Wrench-Wielders-Racing/BMS/Master_V0.1/Master_V0.1_brd_front.pdf

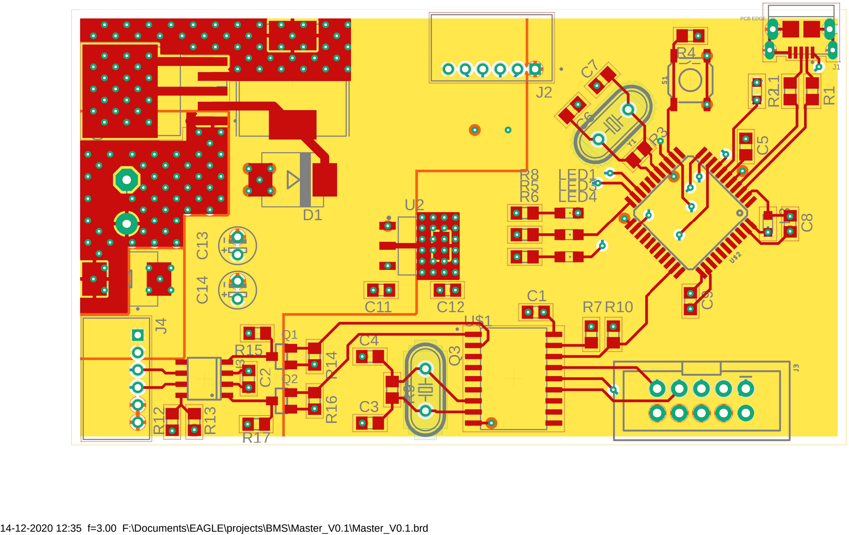
[picture p1: page 1]

14-12-2020 12:35 f=3.00 F:\Documents\EAGLE\projects\BMS\Master_V0.1\Master_V0.1.brd
