Wrench-Wielders-Racing/BMS/Slave_V0.1/Slave_V0.1_BRD.pdf

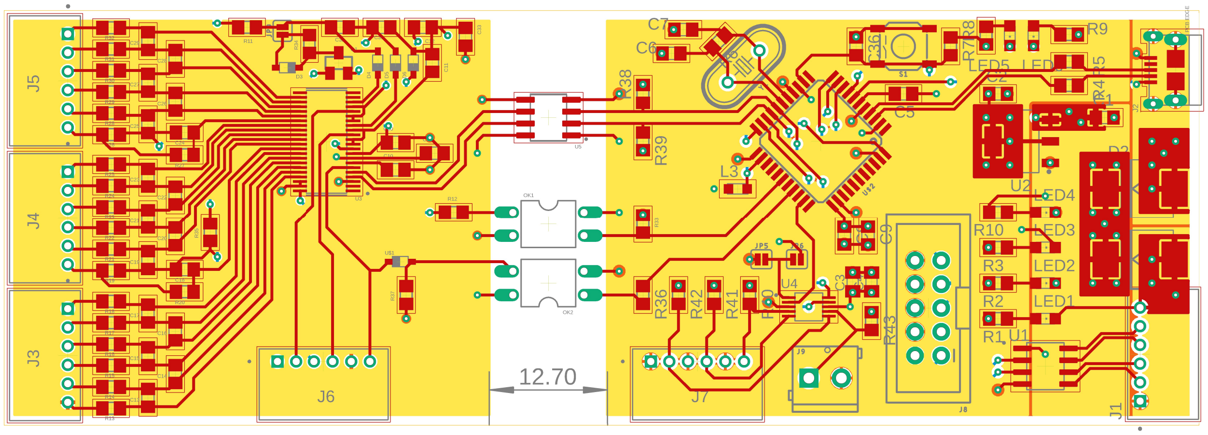
[picture p2: figure]

14-12-2020 15:32 f=2.20 F:\Documents\EAGLE\projects\BMS\Slave_V0.1\Slave_V0.1.brd
