Wrench-Wielders-Racing/BMS/Master_V0.1/Master_V0.1_sch.pdf

# 6 J2

A

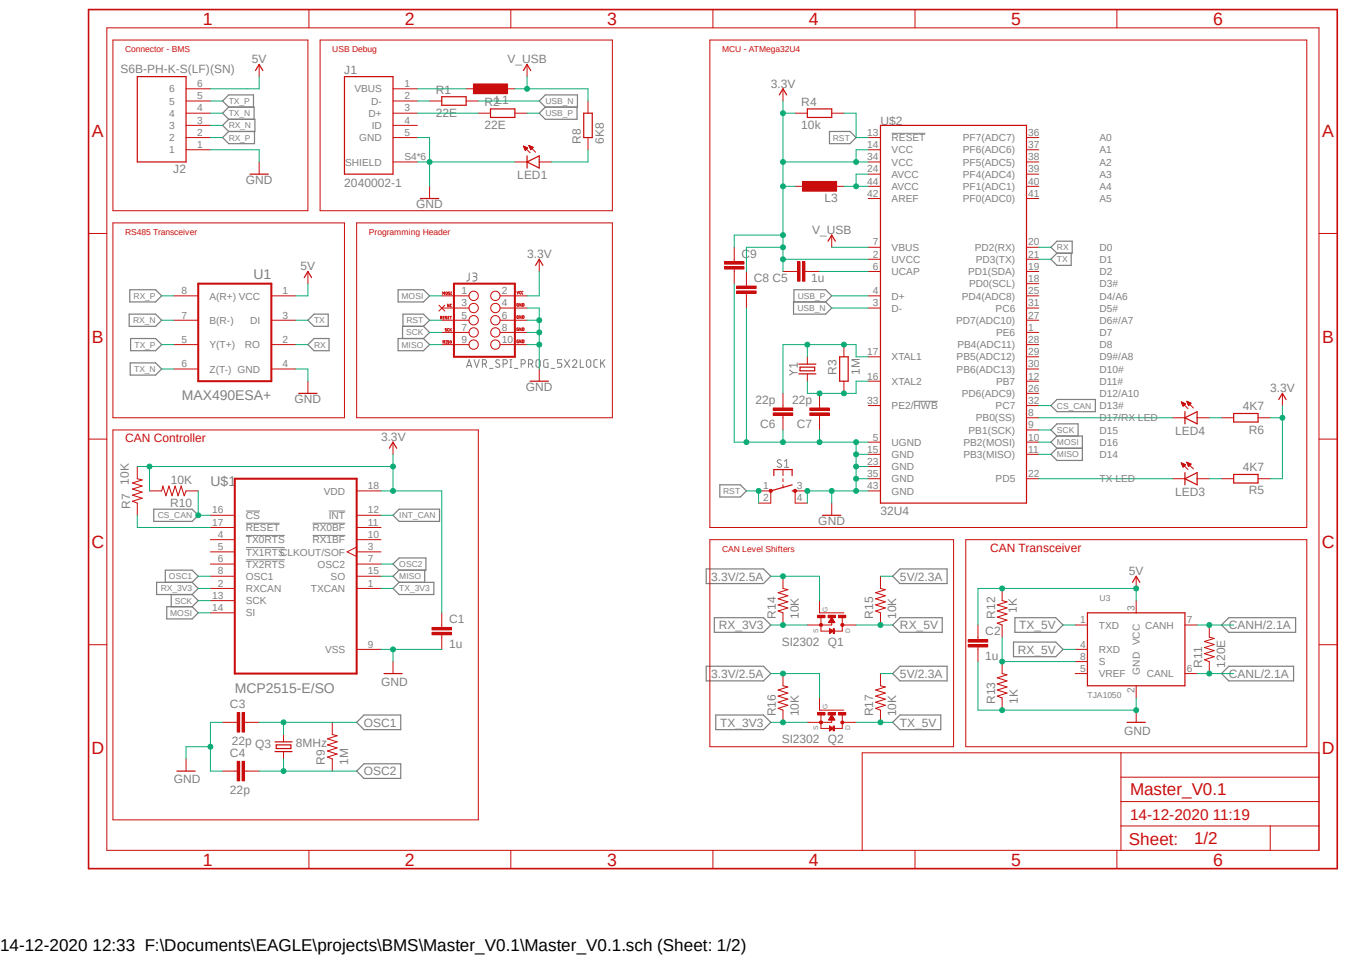
[picture p3: page 1]

14-12-2020 12:33 F:\Documents\EAGLE\projects\BMS\Master_V0.1\Master_V0.1.sch (Sheet: 1/2)

## AMS1117

## LM2596SX-ADJ/NOPB

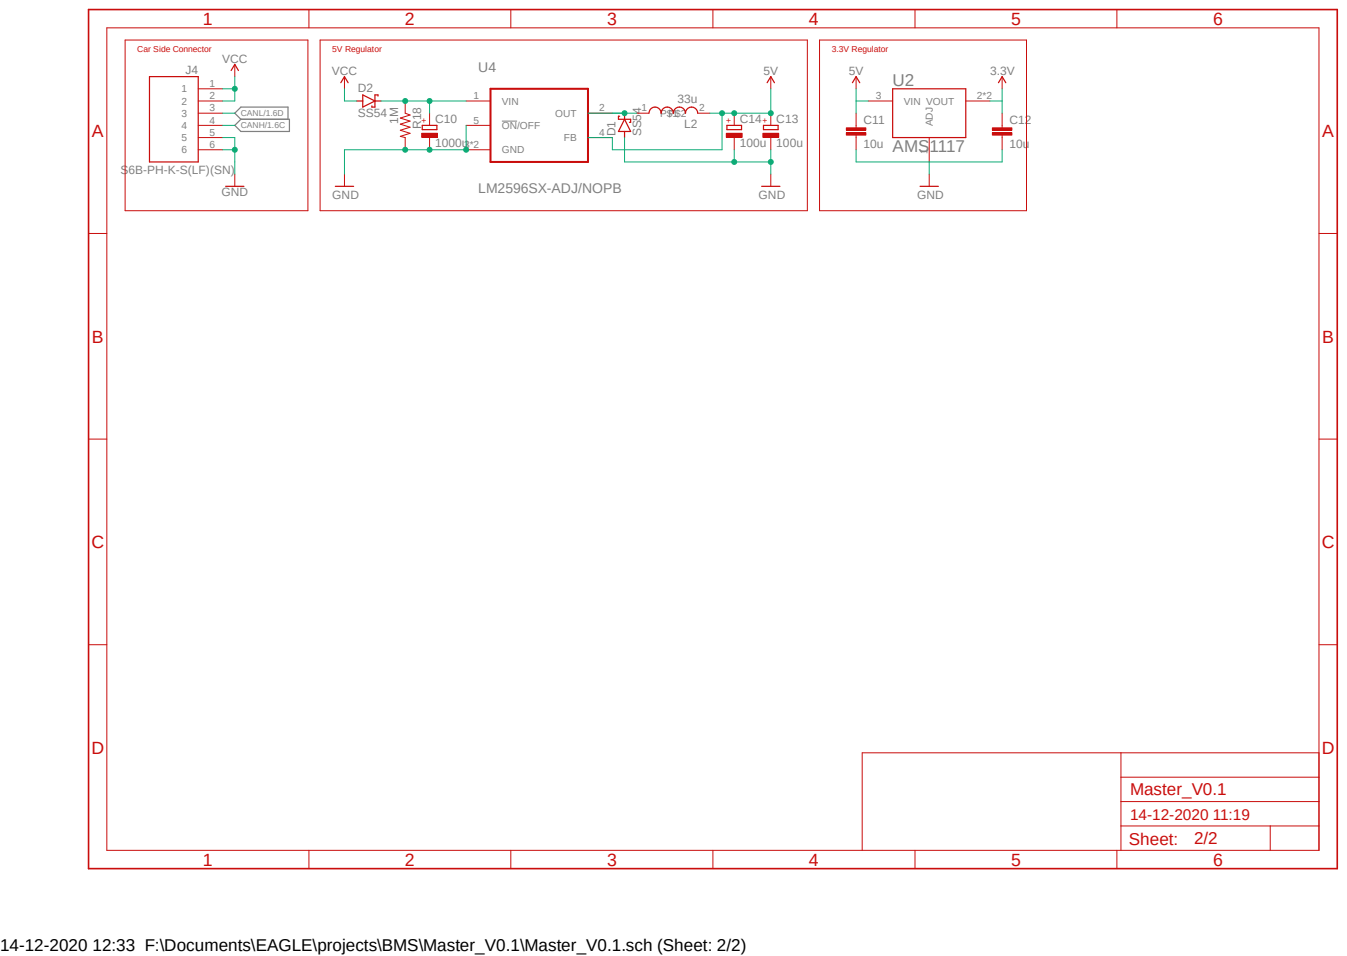
[picture p4: page 2]

14-12-2020 12:33 F:\Documents\EAGLE\projects\BMS\Master_V0.1\Master_V0.1.sch (Sheet: 2/2)
