Wrench-Wielders-Racing/BMS/Slave_V0.1/Slave_V0.1.pdf

# 6 J1

A

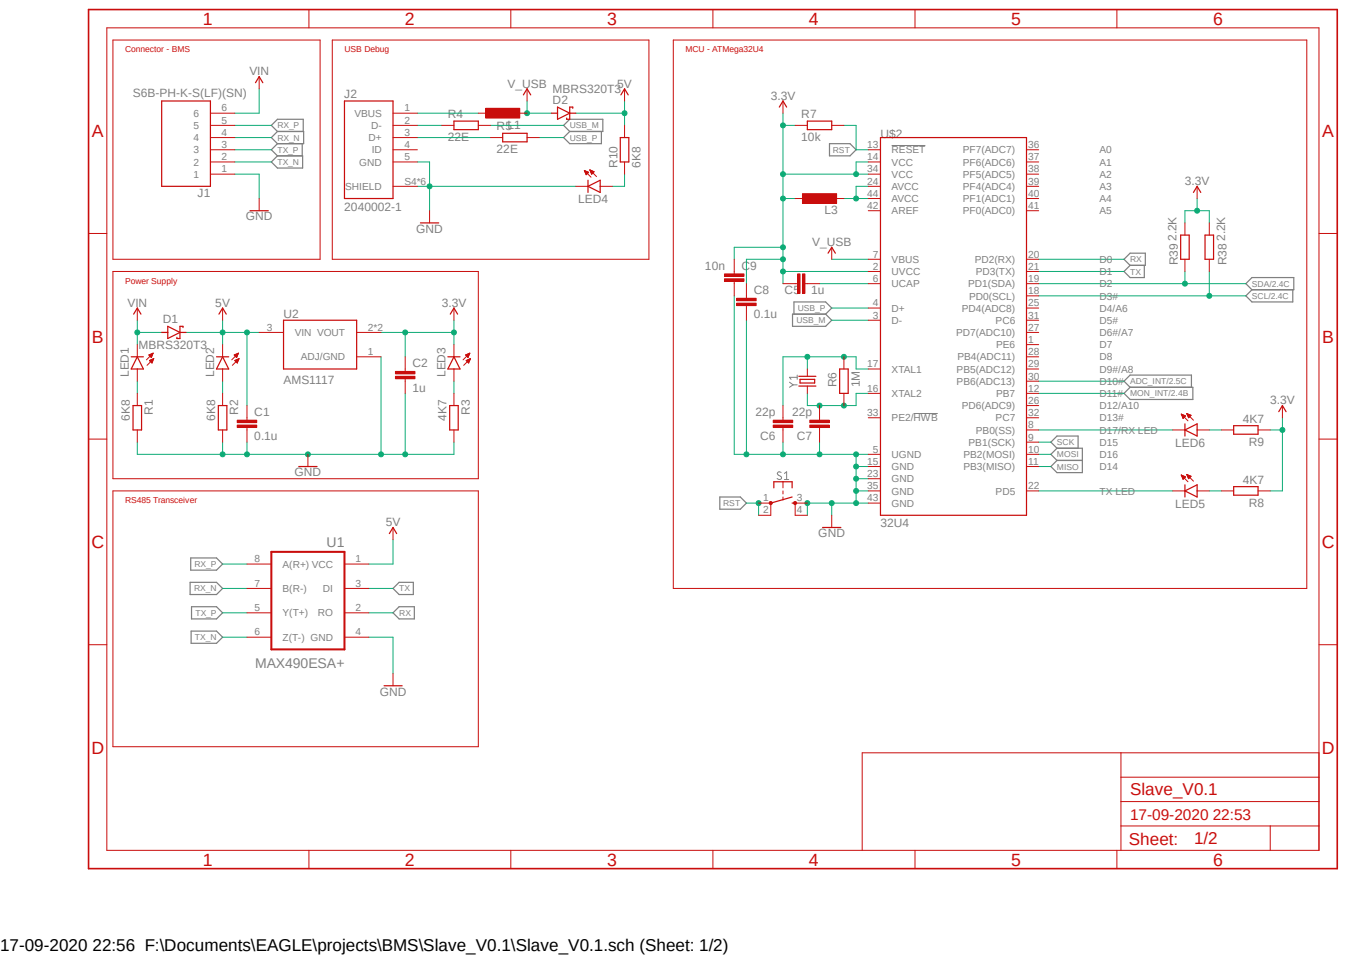
[picture p5: page 1]

17-09-2020 22:56 F:\Documents\EAGLE\projects\BMS\Slave_V0.1\Slave_V0.1.sch (Sheet: 1/2)

# 10uF SD¹⁰³AWS

# 6 J5

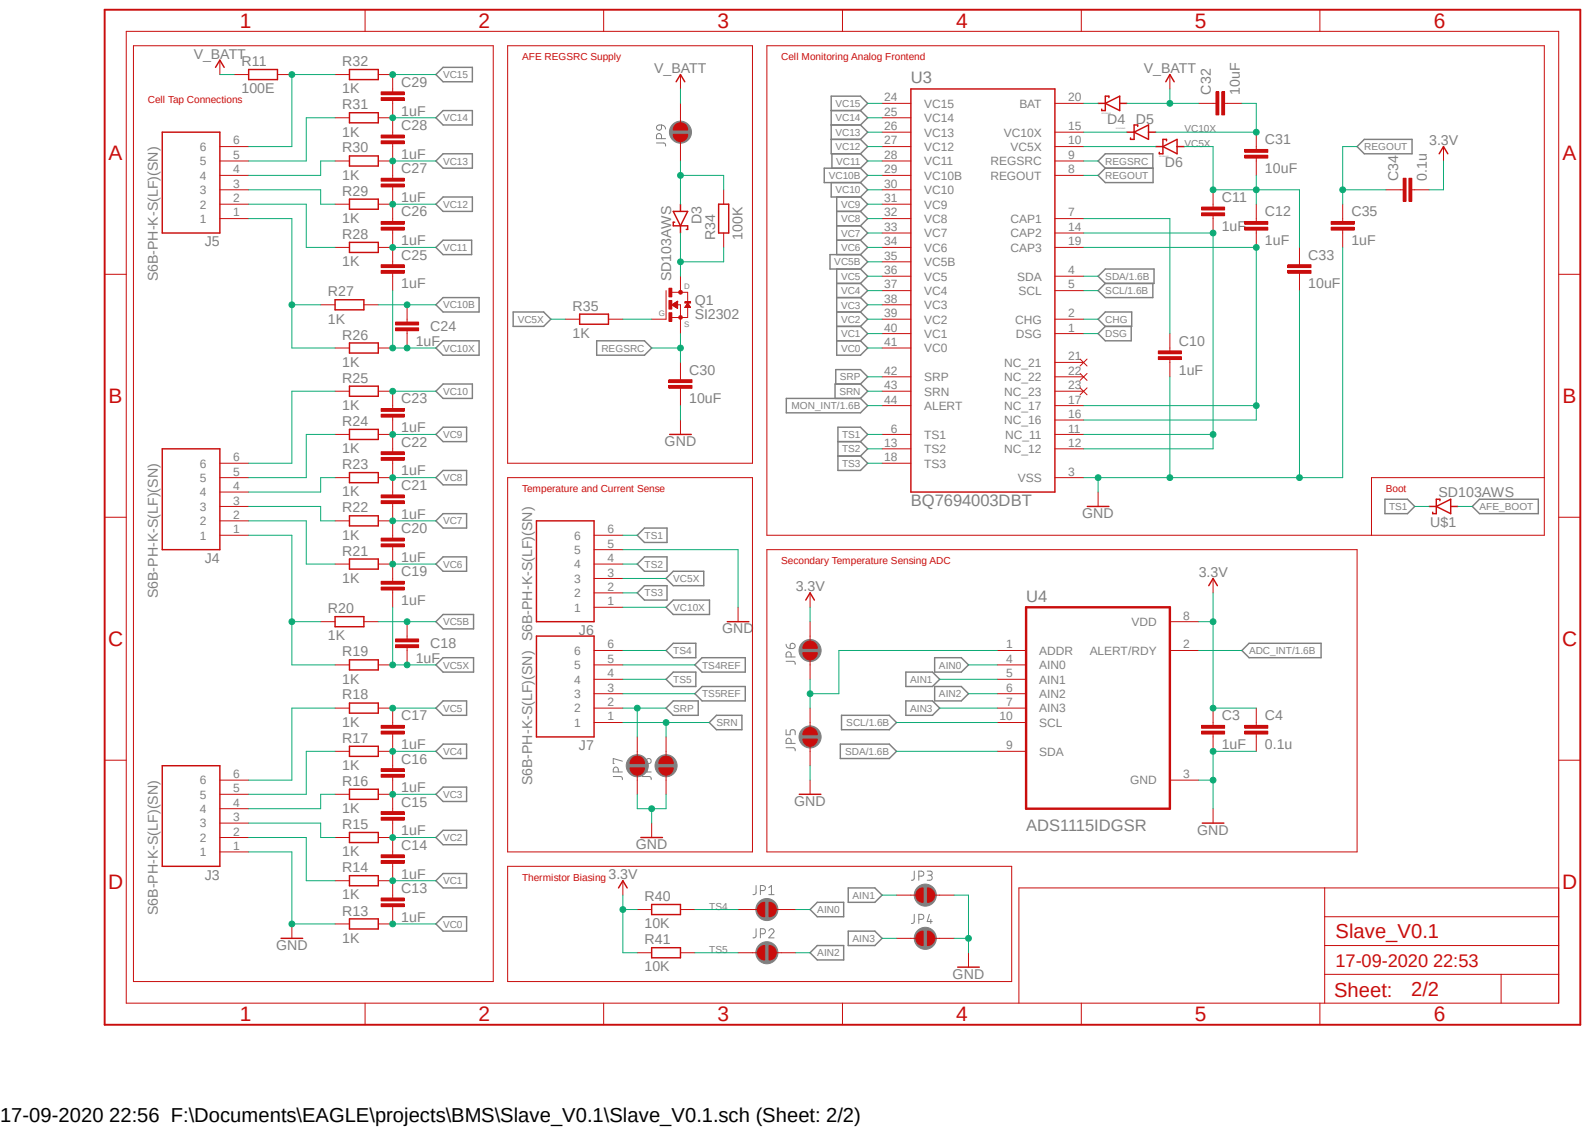
[picture p6: page 2]

Cell Monitoring Analog Frontend

Secondary Temperature Sensing ADC

17-09-2020 22:56 F:\Documents\EAGLE\projects\BMS\Slave_V0.1\Slave_V0.1.sch (Sheet: 2/2)
