Wrench-Wielders-Racing/BMS/Slave_V0.1/Slave_V0.1_SCH.pdf

# 6 J1

A

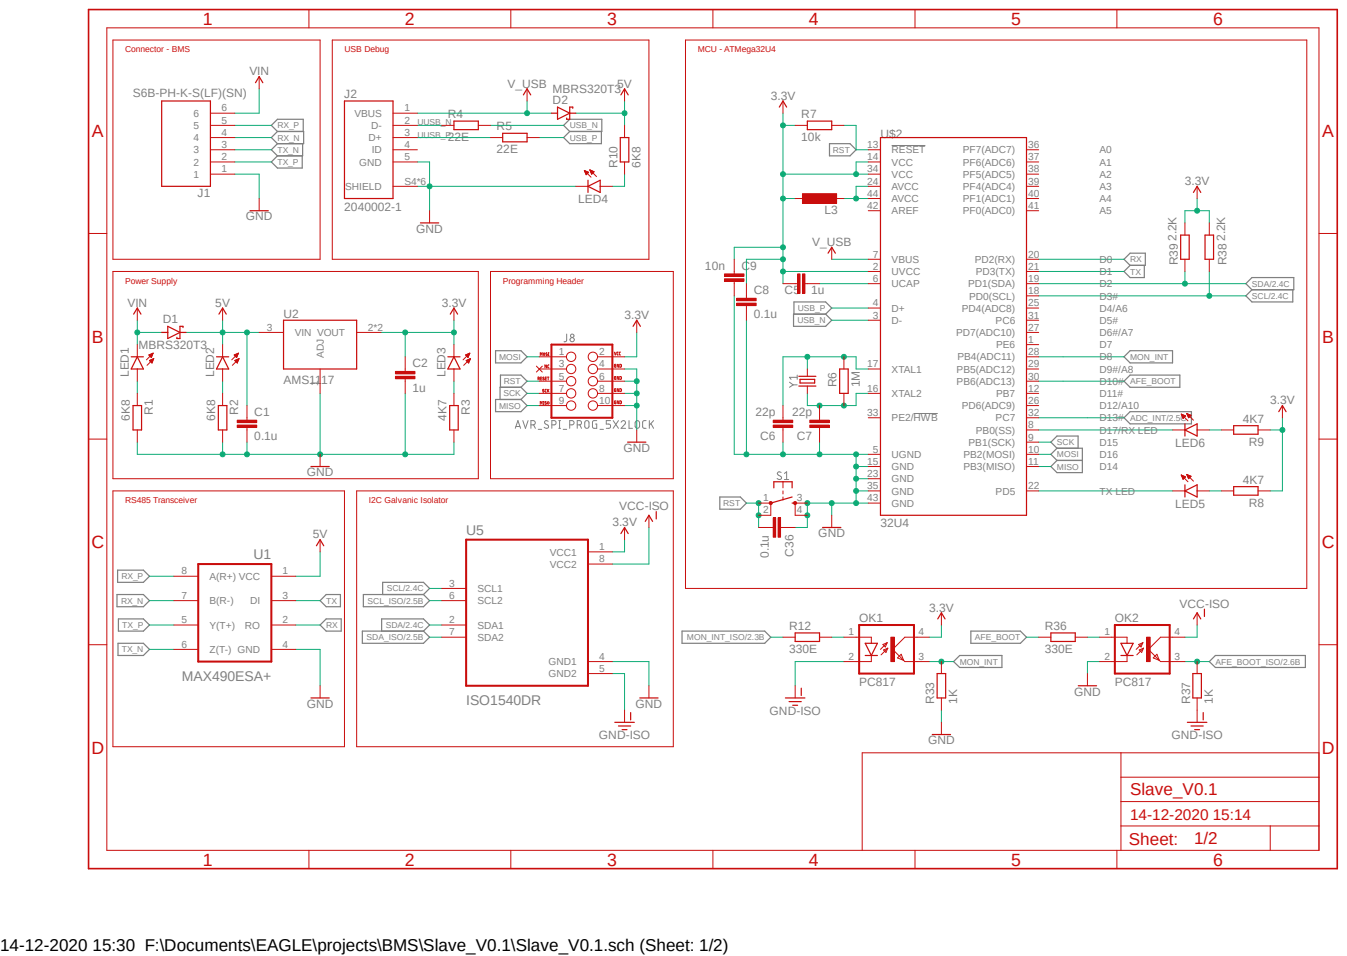
[picture p7: page 1]

14-12-2020 15:30 F:\Documents\EAGLE\projects\BMS\Slave_V0.1\Slave_V0.1.sch (Sheet: 1/2)

# 10uF SD¹⁰³AWS

# 6 J5

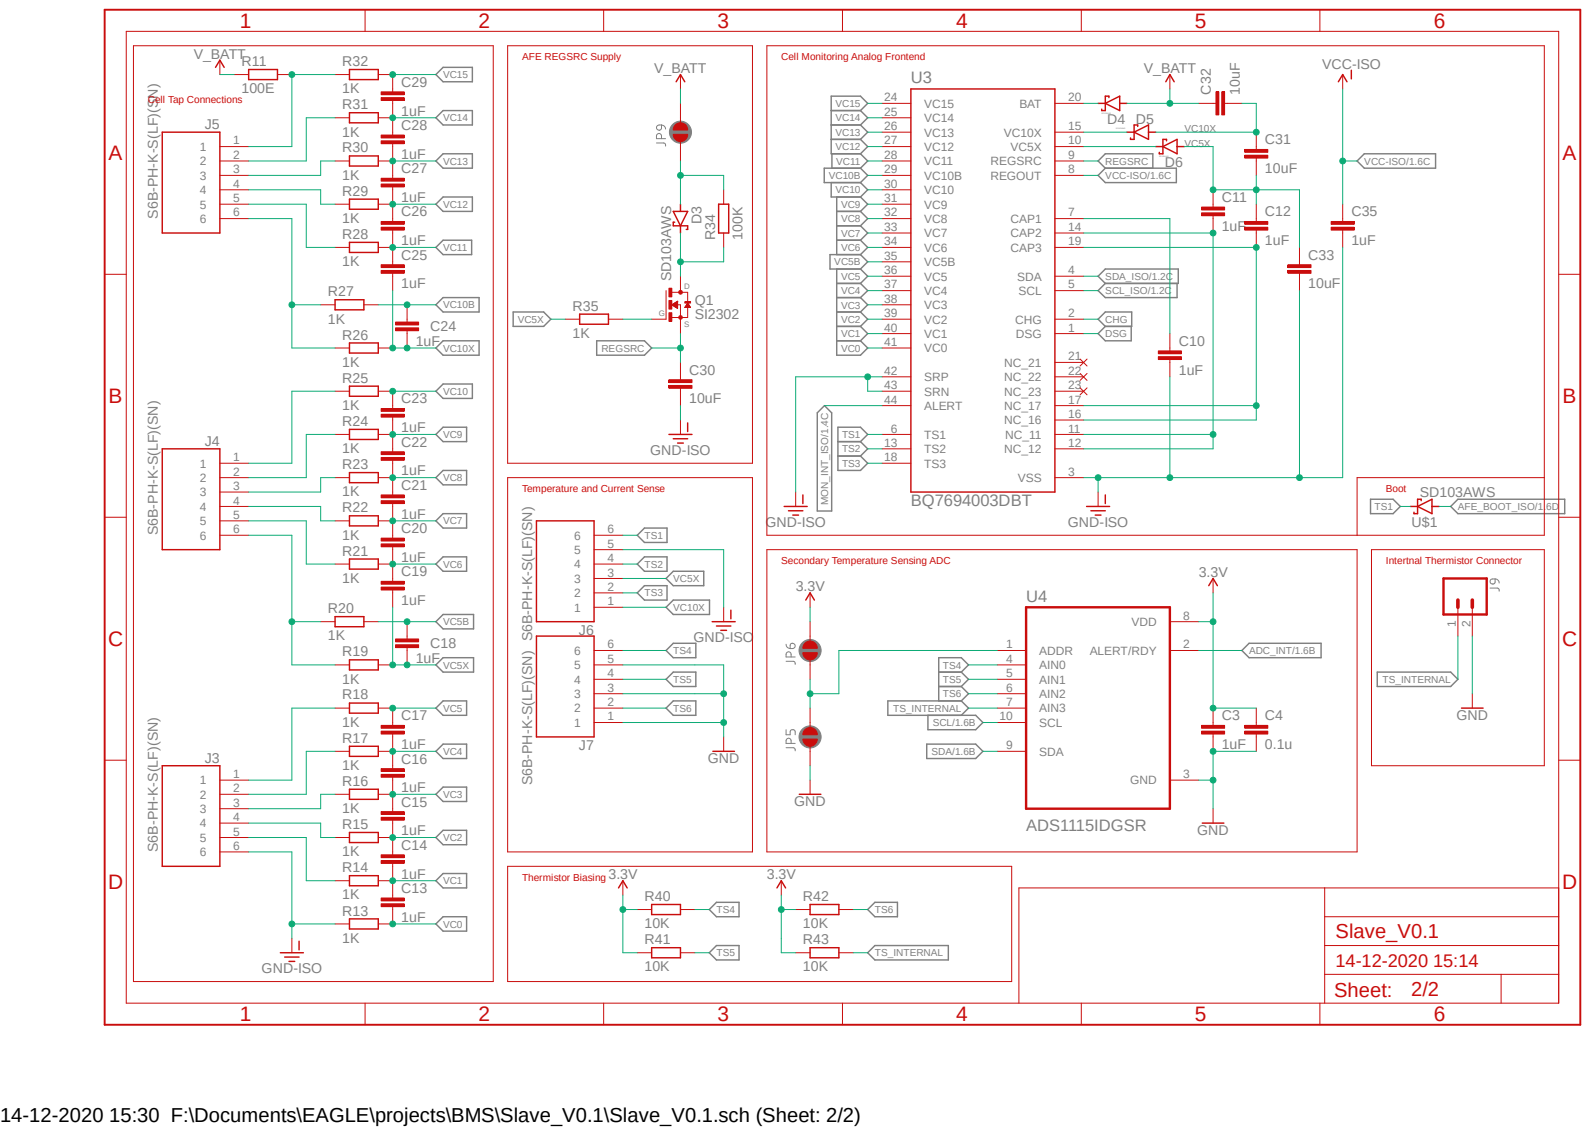
[picture p8: page 2]

Cell Monitoring Analog Frontend

Secondary Temperature Sensing ADC

14-12-2020 15:30 F:\Documents\EAGLE\projects\BMS\Slave_V0.1\Slave_V0.1.sch (Sheet: 2/2)
