Wrench-Wielders-Racing/BMS/Master_V0.1/Master_V0.1.brd

## EAGLE design Master_V0.1/Master_V0.1.brd (2020-12-17)

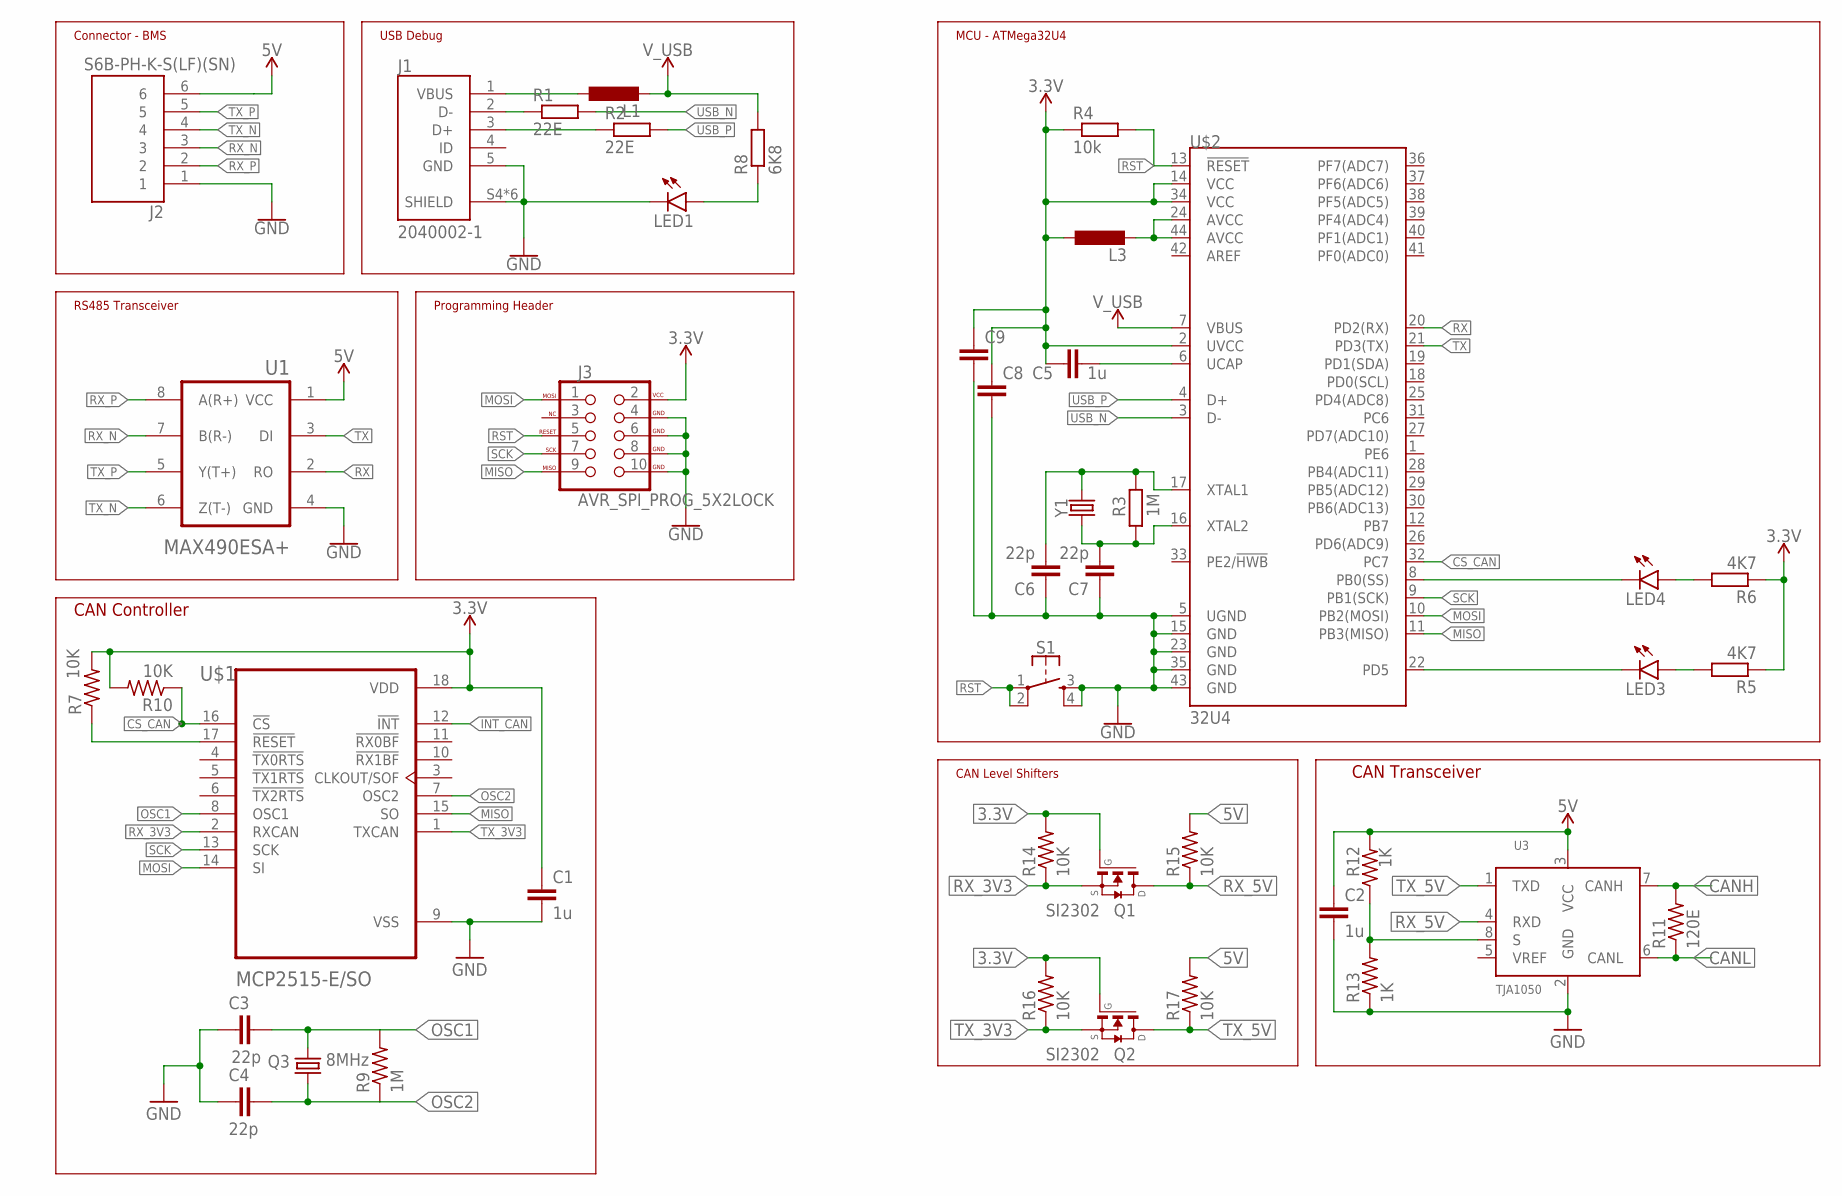
[picture p9: schematic Master_V0.1.sch, sheet 1]

Parts:
C1, C2, C5: 1u; C0805
C3, C4, C6, C7: 22p; C0805
C8, C9: C-EUC0805; C0805
J1: 2040002-1; TE_2040002-1
J2: S6B-PH-K-S(LF)(SN); JST_S6B-PH-K-S(LF)(SN)
J3: AVR_SPI_PROG_5X2LOCK; 2X5-SHROUDED_LOCK
L1, L3: L-EUL2012C; L2012C
LED1, LED3, LED4: LEDCHIPLED_0805; CHIPLED_0805
Q1, Q2: SI2302; SOT23
Q3: 8MHz; HC49/S
R1, R2: 22E; R0805
R3, R9: 1M; R0805
R4: 10k; R0805
R5, R6: 4K7; R0805
R7, R10, R14, R15, R16, R17: 10K; R0805
R8: 6K8; R0805
R11: 120E; R0805
R12, R13: 1K; R0805
S1: MOMENTARY-SWITCH-SPST-2-SMD-5.2MM; TACTILE_SWITCH_SMD_5.2MM
U1: MAX490ESA+; SOIC127P600X175-8N
U3: TJA1050; SOT96-1
U$1: MCP2515-E/SO; SOIC127P1030X265-18N
U$2: 32U4; TQFP44
Y1: CRYSTALPTH-HC49UV; HC49U

Connections:
3.3V: C1.1, C5.1, C8.1, C9.1, J3.2 (VCC), L3.1, Q1.1 (G), Q2.1 (G), R4.1, R5.1, R6.1, R7.2, R10.2, R14.2, R16.2, U$1.18 (VDD), U$2.2 (UVCC), U$2.14 (VCC), U$2.34 (VCC); also elsewhere on the board
5V: C2.1, J2.6, R12.2, R15.2, R17.2, U1.1 (VCC), U3.3 (VCC); also elsewhere on the board
CANH: R11.2, U3.7 (CANH); also elsewhere on the board
CANL: R11.1, U3.6 (CANL); also elsewhere on the board
CS_CAN: R10.1, U$1.16 (!CS), U$2.32 (PC7)
GND: C1.2, C2.2, C3.1, C4.1, C6.1, C7.1, C8.2, C9.2, J1.5 (GND), J1.S4 (SHIELD), J1.S5 (SHIELD), J1.SH1 (SHIELD), J1.SH2 (SHIELD), J1.SH3 (SHIELD), J1.SH4 (SHIELD), J2.1, J3.4 (GND), J3.6 (GND), J3.8 (GND), J3.10 (GND), LED1.C, R13.1, S1.3, S1.4, U1.4 (GND), U3.2 (GND), U$1.9 (VSS), U$2.5 (UGND), U$2.15 (GND), U$2.23 (GND), U$2.35 (GND), U$2.43 (GND); also elsewhere on the board
INT_CAN: U$1.12 (!INT)
MISO: J3.9 (MISO), U$1.15 (SO), U$2.11 (PB3(MISO))
MOSI: J3.1 (MOSI), U$1.14 (SI), U$2.10 (PB2(MOSI))
unnamed: J1.3 (D+), R2.1
unnamed: J1.2 (D-), R1.1
unnamed: J1.1 (VBUS), L1.1
unnamed: L3.2, U$2.24 (AVCC), U$2.44 (AVCC)
unnamed: LED1.A, R8.1
unnamed: R7.1, U$1.17 (!RESET)
unnamed: C5.2, U$2.6 (UCAP)
unnamed: LED3.C, U$2.22 (PD5)
unnamed: C6.2, R3.2, U$2.17 (XTAL1), Y1.2
unnamed: LED3.A, R5.2
unnamed: C7.2, R3.1, U$2.16 (XTAL2), Y1.1
unnamed: LED4.C, U$2.8 (PB0(SS))
unnamed: LED4.A, R6.2
unnamed: R12.1, R13.2, U3.8 (S)
OSC1: C3.2, Q3.2, R9.2, U$1.8 (OSC1)
OSC2: C4.2, Q3.1, R9.1, U$1.7 (OSC2)
RST: J3.5 (RESET), R4.2, S1.1, S1.2, U$2.13 (!RESET)
RX: U1.2 (RO), U$2.20 (PD2(RX))
RX_3V3: Q1.2 (S), R14.1, U$1.2 (RXCAN)
RX_5V: Q1.3 (D), R15.1, U3.4 (RXD)
RX_N: J2.3, U1.7 (B(R-))
RX_P: J2.2, U1.8 (A(R+))
SCK: J3.7 (SCK), U$1.13 (SCK), U$2.9 (PB1(SCK))
TX: U1.3 (DI), U$2.21 (PD3(TX))
TX_3V3: Q2.2 (S), R16.1, U$1.1 (TXCAN)
TX_5V: Q2.3 (D), R17.1, U3.1 (TXD)
TX_N: J2.4, U1.6 (Z(T-))
TX_P: J2.5, U1.5 (Y(T+))
USB_N: R1.2, U$2.3 (D-)
USB_P: R2.2, U$2.4 (D+)
V_USB: L1.2, R8.2, U$2.7 (VBUS)

Notes on the sheet:
Connector - BMS
USB Debug
MCU - ATMega32U4
RS485 Transceiver
Programming Header
CAN Transceiver
CAN Controller
CAN Level Shifters

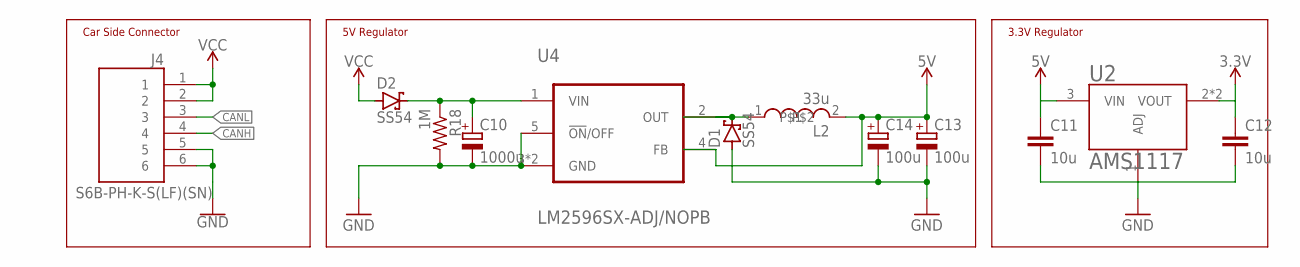
[picture p10: schematic Master_V0.1.sch, sheet 2]

Parts:
C10: 1000u; E5-10,5
C11, C12: 10u; C0805
C13, C14: 100u; E2-4
D1, D2: SS54; SMC
J4: S6B-PH-K-S(LF)(SN); JST_S6B-PH-K-S(LF)(SN)
L2: 33u; CDRH127/LD
R18: 1M; R0805
U2: AMS1117; SOT230P700X170-4
U4: LM2596SX-ADJ/NOPB; VREG_LM2596SX-ADJ/NOPB

Connections:
3.3V: C12.1, U2.2 (VOUT), U2.4 (VOUT); also elsewhere on the board
5V: C11.1, C13.+, C14.+, L2.2, U2.3 (VIN), U4.4 (FB); also elsewhere on the board
CANH: J4.4; also elsewhere on the board
CANL: J4.3; also elsewhere on the board
GND: C10.-, C11.2, C12.2, C13.-, C14.-, D1.A, J4.5, J4.6, R18.2, U2.1 (ADJ), U4.3 (GND), U4.5 (!ON!/OFF), U4.6 (GND); also elsewhere on the board
unnamed: D1.C, L2.1, U4.2 (OUT)
unnamed: C10.+, D2.C, R18.1, U4.1 (VIN)
VCC: D2.A, J4.1, J4.2

Notes on the sheet:
Car Side Connector
5V Regulator
3.3V Regulator

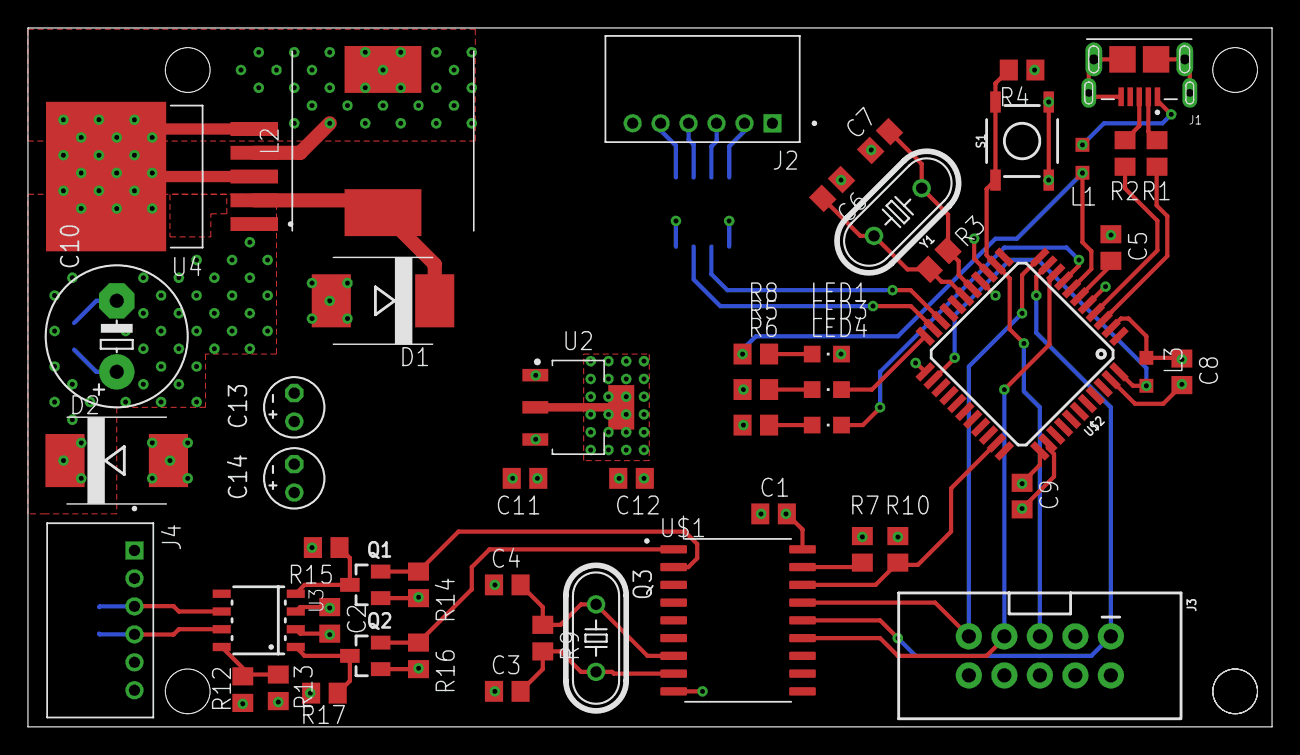
[picture p11: board Master_V0.1.brd from above]

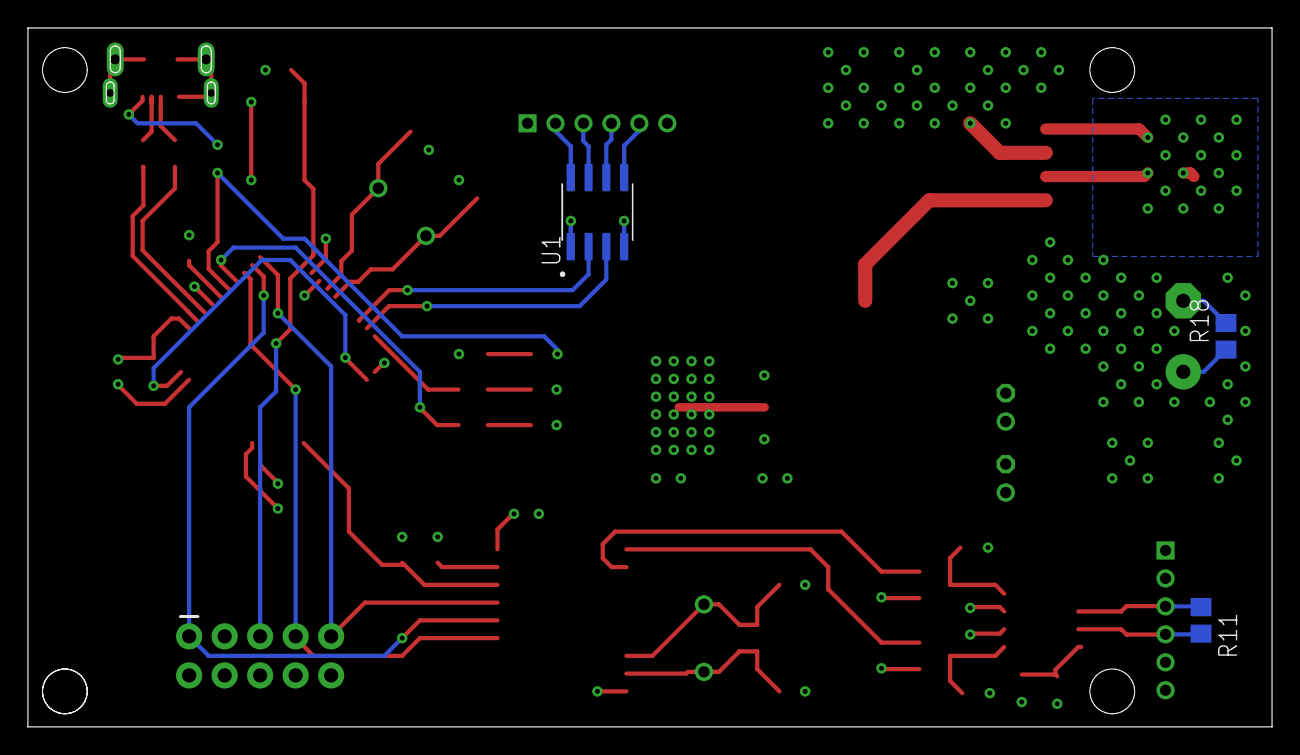
[picture p12: board Master_V0.1.brd from below]

Board: 4 copper layers, 89.0 x 50.0 mm, 55 parts (3 on the bottom side), 42 nets.
