Wrench-Wielders-Racing/BMS/Slave_V0.1/Slave_V0.1.brd

## EAGLE design Slave_V0.1/Slave_V0.1.brd (2020-12-17)

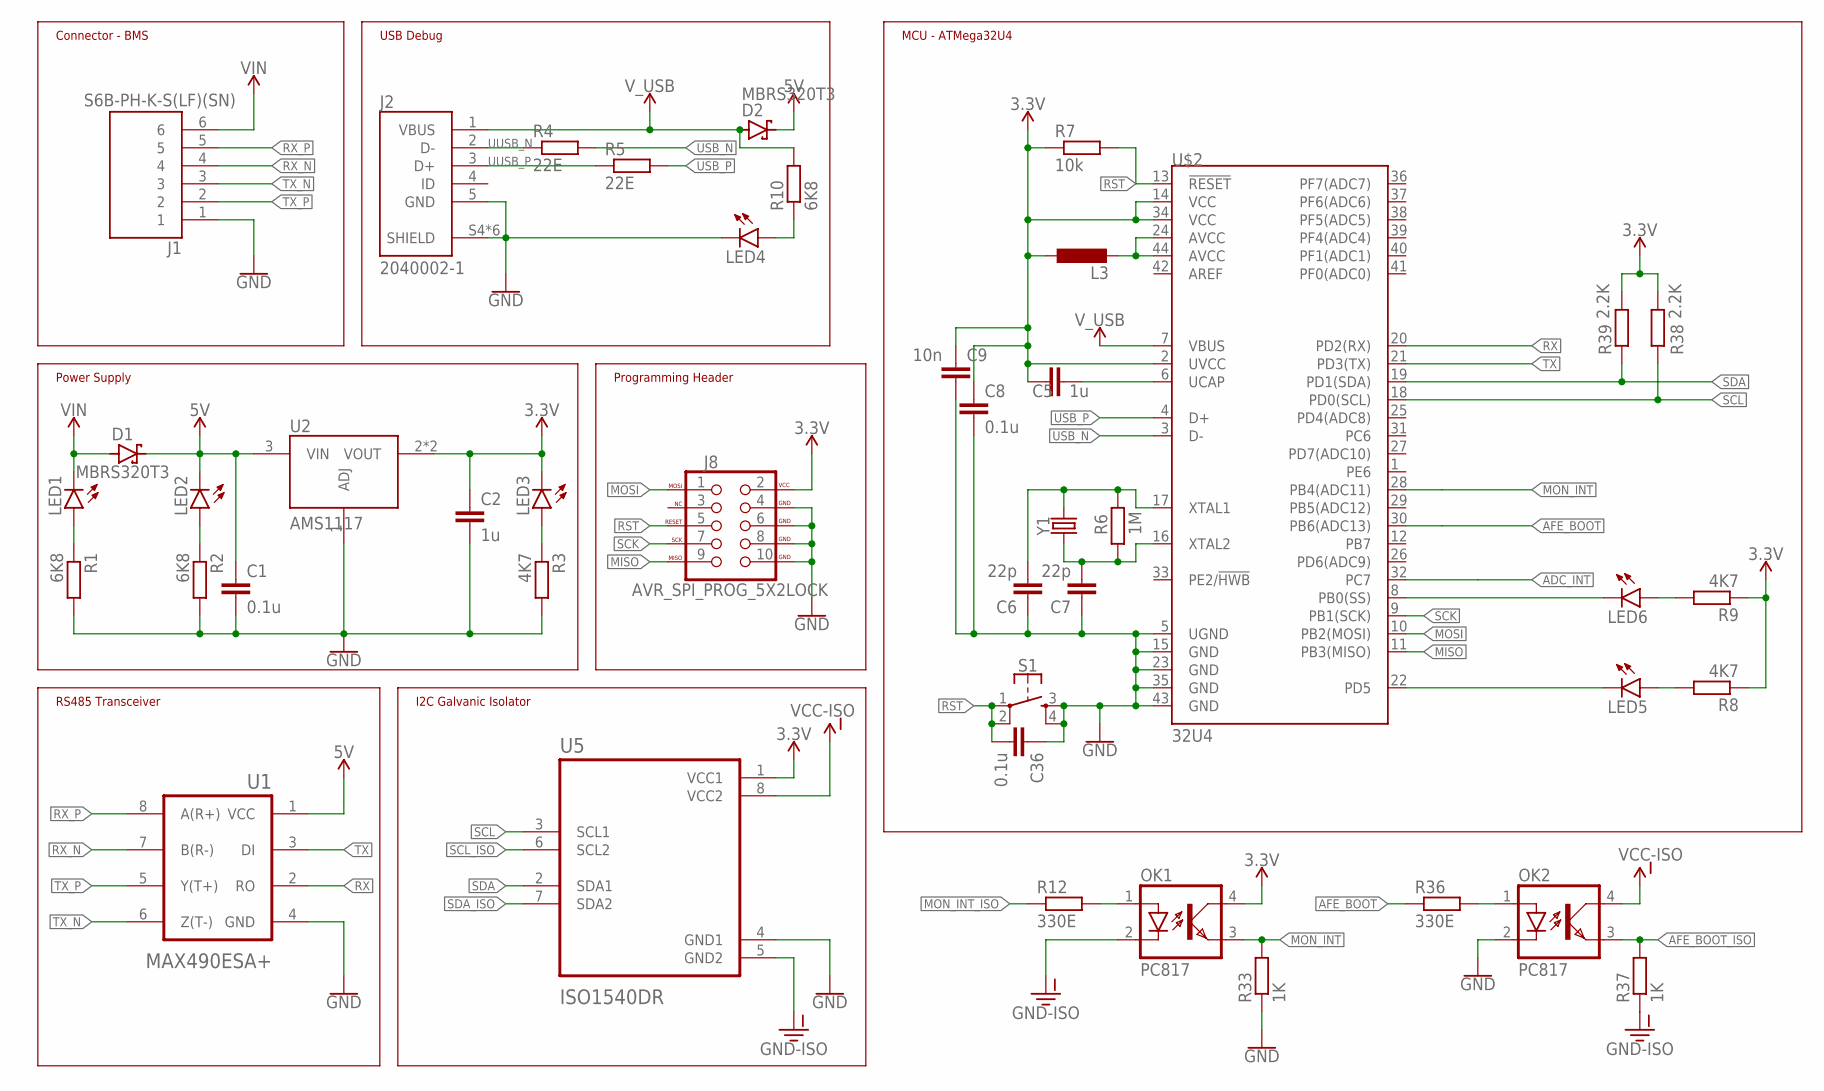
[picture p13: schematic Slave_V0.1.sch, sheet 1]

Parts:
C1, C8, C36: 0.1u; C0805
C2, C5: 1u; C0805
C6, C7: 22p; C0805
C9: 10n; C0805
D1, D2: MBRS320T3; SMC
J1: S6B-PH-K-S(LF)(SN); JST_S6B-PH-K-S(LF)(SN)
J2: 2040002-1; TE_2040002-1
J8: AVR_SPI_PROG_5X2LOCK; 2X5-SHROUDED_LOCK
L3: L-EUL2012C; L2012C
LED1, LED2, LED3, LED4, LED5, LED6: LEDCHIPLED_0805; CHIPLED_0805
OK1, OK2: PC817; DIL04
R1, R2, R10: 6K8; R0805
R3, R8, R9: 4K7; R0805
R4, R5: 22E; R0805
R6: 1M; R0805
R7: 10k; R0805
R12, R36: 330E; R0805
R33, R37: 1K; R0805
R38, R39: 2.2K; R0805
S1: MOMENTARY-SWITCH-SPST-2-SMD-5.2MM; TACTILE_SWITCH_SMD_5.2MM
U1: MAX490ESA+; SOIC127P600X175-8N
U2: AMS1117; SOT230P700X170-4
U5: ISO1540DR; SOIC127P599X175-8N
U$2: 32U4; TQFP44
Y1: CRYSTALPTH-HC49UV; HC49U

Connections:
3.3V: C2.1, C5.1, C8.1, C9.1, J8.2 (VCC), L3.1, LED3.C, OK1.4 (COL), R7.1, R8.1, R9.1, R38.2, R39.2, U2.2 (VOUT), U2.4 (VOUT), U5.1 (VCC1), U$2.2 (UVCC), U$2.14 (VCC), U$2.34 (VCC); also elsewhere on the board
5V: C1.1, D1.C, D2.C, LED2.C, U1.1 (VCC), U2.3 (VIN)
ADC_INT: U$2.32 (PC7); also elsewhere on the board
AFE_BOOT: R36.1, U$2.30 (PB6(ADC13))
AFE_BOOT_ISO: OK2.3 (EMIT), R37.2; also elsewhere on the board
GND: C1.2, C2.2, C6.1, C7.1, C8.2, C9.2, C36.1, J1.1, J2.5 (GND), J2.S4 (SHIELD), J2.S5 (SHIELD), J2.SH1 (SHIELD), J2.SH2 (SHIELD), J2.SH3 (SHIELD), J2.SH4 (SHIELD), J8.4 (GND), J8.6 (GND), J8.8 (GND), J8.10 (GND), LED4.C, OK2.2 (C), R1.2, R2.2, R3.2, R33.1, S1.3, S1.4, U1.4 (GND), U2.1 (ADJ), U5.4 (GND1), U$2.5 (UGND), U$2.15 (GND), U$2.23 (GND), U$2.35 (GND), U$2.43 (GND); also elsewhere on the board
GND-ISO: OK1.2 (C), R37.1, U5.5 (GND2); also elsewhere on the board
MISO: J8.9 (MISO), U$2.11 (PB3(MISO))
MON_INT: OK1.3 (EMIT), R33.2, U$2.28 (PB4(ADC11))
MON_INT_ISO: R12.1; also elsewhere on the board
MOSI: J8.1 (MOSI), U$2.10 (PB2(MOSI))
unnamed: LED1.A, R1.1
unnamed: LED3.A, R3.1
unnamed: LED2.A, R2.1
unnamed: L3.2, U$2.24 (AVCC), U$2.44 (AVCC)
unnamed: C5.2, U$2.6 (UCAP)
unnamed: C6.2, R6.2, U$2.17 (XTAL1), Y1.2
unnamed: LED5.C, U$2.22 (PD5)
unnamed: C7.2, R6.1, U$2.16 (XTAL2), Y1.1
unnamed: LED5.A, R8.2
unnamed: LED6.C, U$2.8 (PB0(SS))
unnamed: LED6.A, R9.2
unnamed: LED4.A, R10.1
unnamed: OK2.1 (A), R36.2
unnamed: OK1.1 (A), R12.2
RST: C36.2, J8.5 (RESET), R7.2, S1.1, S1.2, U$2.13 (!RESET)
RX: U1.2 (RO), U$2.20 (PD2(RX))
RX_N: J1.4, U1.7 (B(R-))
RX_P: J1.5, U1.8 (A(R+))
SCK: J8.7 (SCK), U$2.9 (PB1(SCK))
SCL: R38.1, U5.3 (SCL1), U$2.18 (PD0(SCL)); also elsewhere on the board
SCL_ISO: U5.6 (SCL2); also elsewhere on the board
SDA: R39.1, U5.2 (SDA1), U$2.19 (PD1(SDA)); also elsewhere on the board
SDA_ISO: U5.7 (SDA2); also elsewhere on the board
TX: U1.3 (DI), U$2.21 (PD3(TX))
TX_N: J1.3, U1.6 (Z(T-))
TX_P: J1.2, U1.5 (Y(T+))
USB_N: R4.2, U$2.3 (D-)
USB_P: R5.2, U$2.4 (D+)
UUSB_N: J2.2 (D-), R4.1
UUSB_P: J2.3 (D+), R5.1
VCC-ISO: OK2.4 (COL), U5.8 (VCC2); also elsewhere on the board
VIN: D1.A, J1.6, LED1.C
V_USB: D2.A, J2.1 (VBUS), R10.2, U$2.7 (VBUS)

Notes on the sheet:
Connector - BMS
Power Supply
USB Debug
MCU - ATMega32U4
RS485 Transceiver
I2C Galvanic Isolator
Programming Header

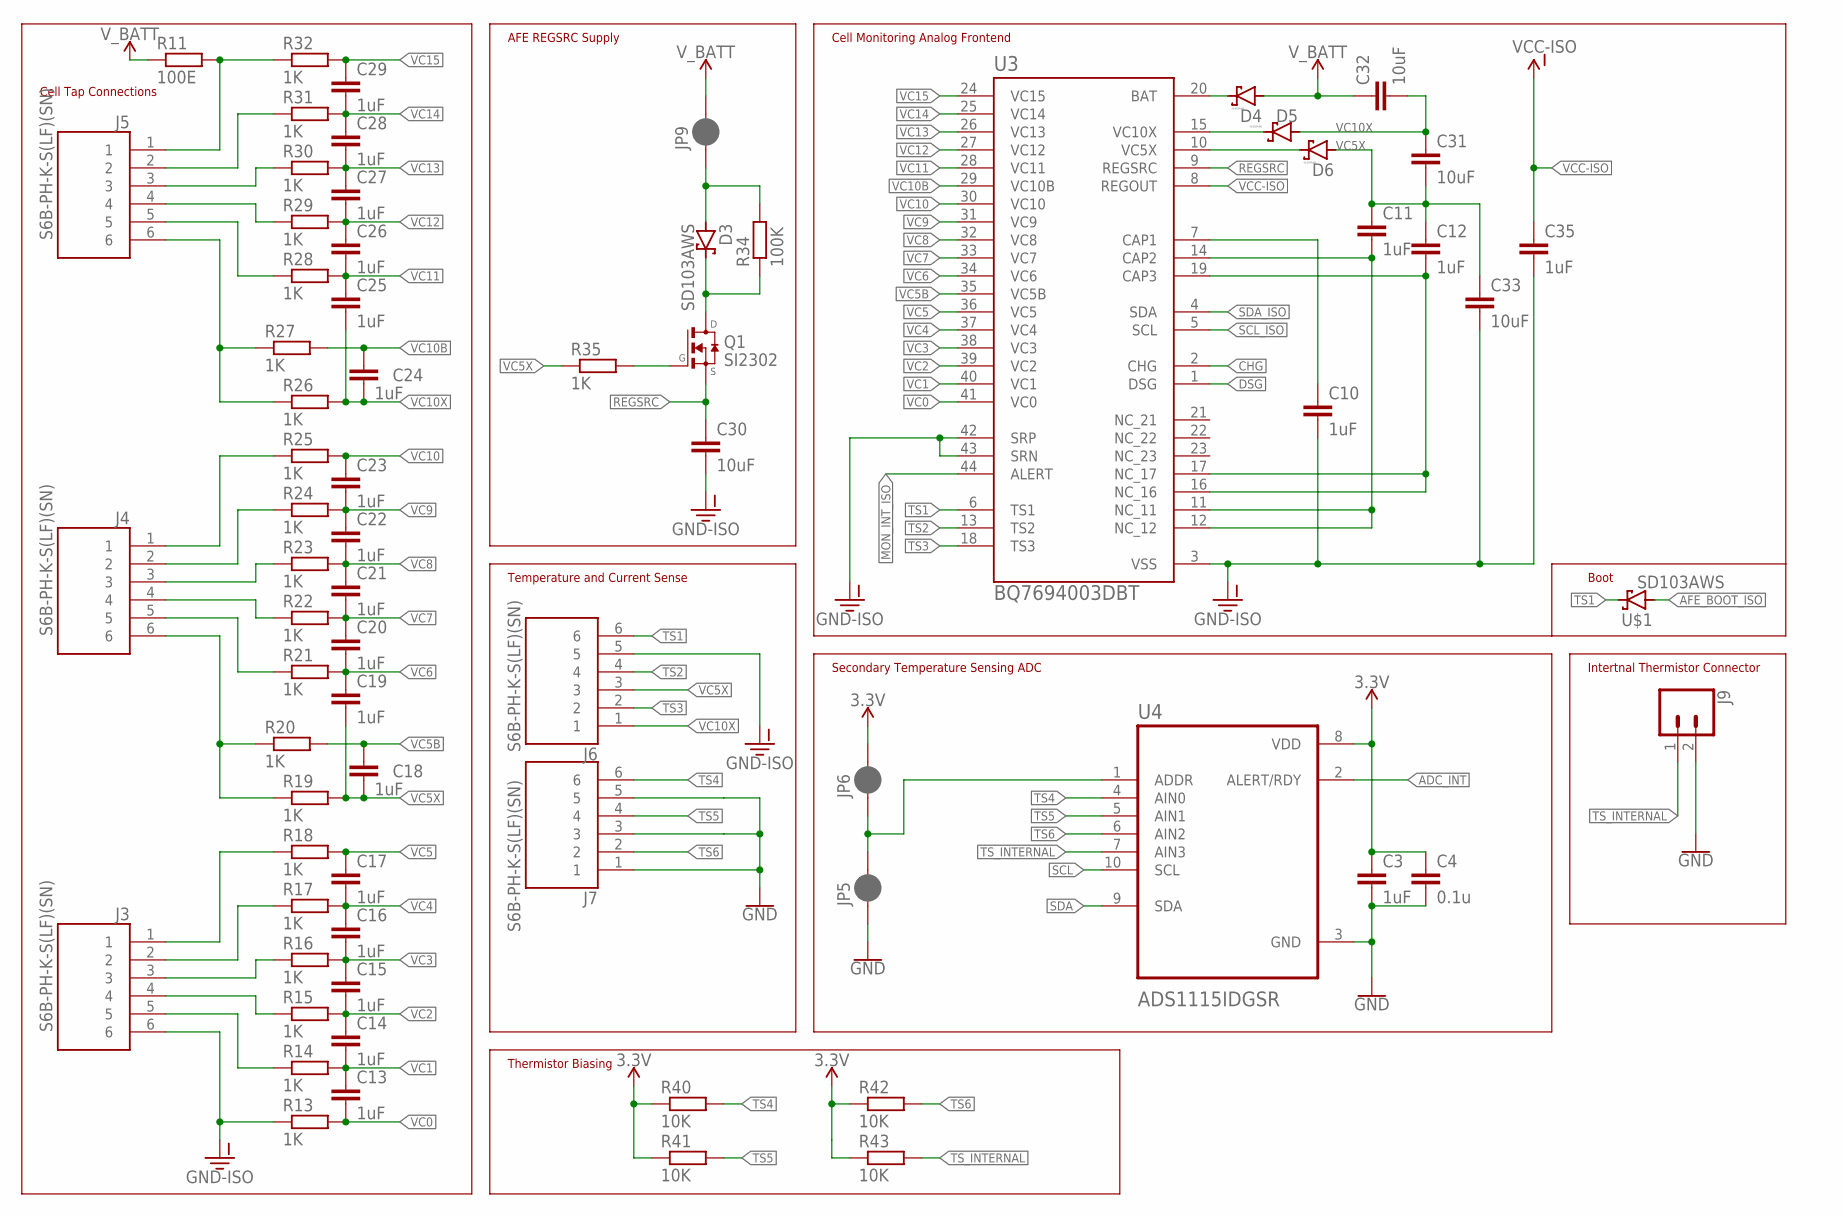
[picture p14: schematic Slave_V0.1.sch, sheet 2]

Parts:
C3: 1uF; C0805K
C4: 0.1u; C0805K
C10, C11, C12, C13, C14, C15, C16, C17, C18, C19, C20, C21, C22, C23, C24, C25, C26, C27, C28, C29, C35: 1uF; C0805
C30, C31, C32, C33: 10uF; C0805
D3, D4, D5, D6: SD103AWS; SOD323_ST
J3, J4, J5, J6, J7: S6B-PH-K-S(LF)(SN); JST_S6B-PH-K-S(LF)(SN)
J9: CONN_023.5MM-NO_SILK; SCREWTERMINAL-3.5MM-2-NS
JP5, JP6, JP9: JUMPER-SMT_2_NC_PASTE_SILK; SMT-JUMPER_2_NC_PASTE_SILK
Q1: SI2302; SOT23
R11: 100E; R0805
R13, R14, R15, R16, R17, R18, R19, R20, R21, R22, R23, R24, R25, R26, R27, R28, R29, R30, R31, R32, R35: 1K; R0805
R34: 100K; R0805
R40, R41, R42, R43: 10K; R0805
U3: BQ7694003DBT; SOP50P640X120-44N
U4: ADS1115IDGSR; SOP50P490X110-10N
U$1: SD103AWS; SOD323_ST

Connections:
3.3V: C3.1, C4.1, JP6.2, R40.1, R41.1, R42.1, R43.1, U4.8 (VDD); also elsewhere on the board
ADC_INT: U4.2 (ALERT/RDY); also elsewhere on the board
AFE_BOOT_ISO: U$1.A; also elsewhere on the board
CHG: U3.2 (CHG)
DSG: U3.1 (DSG)
GND: C3.2, C4.2, J7.1, J7.3, J7.5, J9.2, JP5.1, U4.3 (GND); also elsewhere on the board
GND-ISO: C10.2, C30.2, C33.2, C35.2, J3.6, J6.5, R13.1, U3.3 (VSS), U3.42 (SRP), U3.43 (SRN); also elsewhere on the board
MON_INT_ISO: U3.44 (ALERT); also elsewhere on the board
unnamed: JP5.2, JP6.1, U4.1 (ADDR)
unnamed: C10.1, U3.7 (CAP1)
unnamed: C11.2, U3.11 (NC_11), U3.12 (NC_12), U3.14 (CAP2)
unnamed: D3.A, JP9.1, R34.2
unnamed: D3.C, Q1.3 (D), R34.1
unnamed: C12.2, U3.16 (NC_16), U3.17 (NC_17), U3.19 (CAP3)
unnamed: J4.4, R22.1
unnamed: J4.3, R23.1
unnamed: J4.2, R24.1
unnamed: J4.5, R21.1
unnamed: J4.6, R19.1, R20.1
unnamed: J4.1, R25.1
unnamed: J3.4, R15.1
unnamed: J3.3, R16.1
unnamed: J3.2, R17.1
unnamed: J3.5, R14.1
unnamed: J5.4, R29.1
unnamed: J3.1, R18.1
unnamed: J5.3, R30.1
unnamed: J5.2, R31.1
unnamed: J5.5, R28.1
unnamed: J5.6, R26.1, R27.1
unnamed: Q1.1 (G), R35.2
unnamed: J5.1, R11.2, R32.1
unnamed: D4.C, U3.20 (BAT)
unnamed: D5.C, U3.15 (VC10X)
unnamed: D6.C, U3.10 (VC5X)
REGSRC: C30.1, Q1.2 (S), U3.9 (REGSRC)
SCL: U4.10 (SCL); also elsewhere on the board
SCL_ISO: U3.5 (SCL); also elsewhere on the board
SDA: U4.9 (SDA); also elsewhere on the board
SDA_ISO: U3.4 (SDA); also elsewhere on the board
TS1: J6.6, U3.6 (TS1), U$1.C
TS2: J6.4, U3.13 (TS2)
TS3: J6.2, U3.18 (TS3)
TS4: J7.6, R40.2, U4.4 (AIN0)
TS5: J7.4, R41.2, U4.5 (AIN1)
TS6: J7.2, R42.2, U4.6 (AIN2)
TS_INTERNAL: J9.1, R43.2, U4.7 (AIN3)
VC0: C13.2, R13.2, U3.41 (VC0)
VC1: C13.1, C14.2, R14.2, U3.40 (VC1)
VC2: C14.1, C15.2, R15.2, U3.39 (VC2)
VC3: C15.1, C16.2, R16.2, U3.38 (VC3)
VC4: C16.1, C17.2, R17.2, U3.37 (VC4)
VC5: C17.1, R18.2, U3.36 (VC5)
VC5B: C18.1, R20.2, U3.35 (VC5B)
VC5X: C11.1, C12.1, C18.2, C19.2, C31.2, C33.1, D6.A, J6.3, R19.2, R35.1
VC6: C19.1, C20.2, R21.2, U3.34 (VC6)
VC7: C20.1, C21.2, R22.2, U3.33 (VC7)
VC8: C21.1, C22.2, R23.2, U3.32 (VC8)
VC9: C22.1, C23.2, R24.2, U3.31 (VC9)
VC10: C23.1, R25.2, U3.30 (VC10)
VC10B: C24.1, R27.2, U3.29 (VC10B)
VC10X: C24.2, C25.2, C31.1, C32.2, D5.A, J6.1, R26.2
VC11: C25.1, C26.2, R28.2, U3.28 (VC11)
VC12: C26.1, C27.2, R29.2, U3.27 (VC12)
VC13: C27.1, C28.2, R30.2, U3.26 (VC13)
VC14: C28.1, C29.2, R31.2, U3.25 (VC14)
VC15: C29.1, R32.2, U3.24 (VC15)
VCC-ISO: C35.1, U3.8 (REGOUT); also elsewhere on the board
V_BATT: C32.1, D4.A, JP9.2, R11.1

Notes on the sheet:
Cell Tap Connections
AFE REGSRC Supply
Temperature and Current Sense
Cell Monitoring Analog Frontend
Secondary Temperature Sensing ADC
Boot
Thermistor Biasing
Intertnal Thermistor Connector

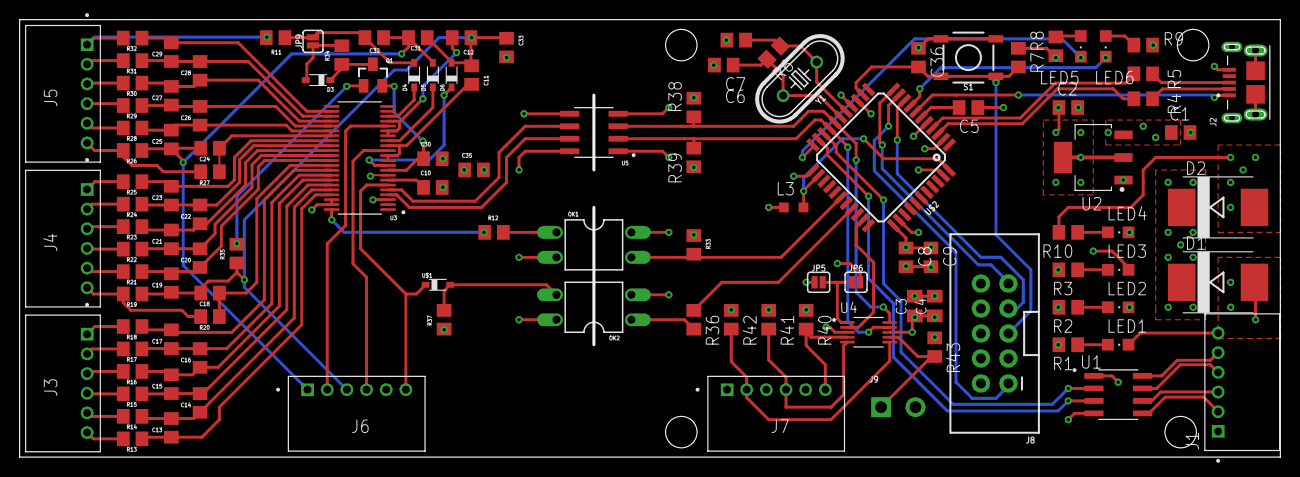
[picture p15: board Slave_V0.1.brd from above]

Board: 4 copper layers, 128.2 x 44.5 mm, 115 parts (0 on the bottom side), 100 nets.
